cdg66/Emergency_Linux_Computer/3d models/AT24CS02_MAHM_T/AT24CS02-MAHM-T.step

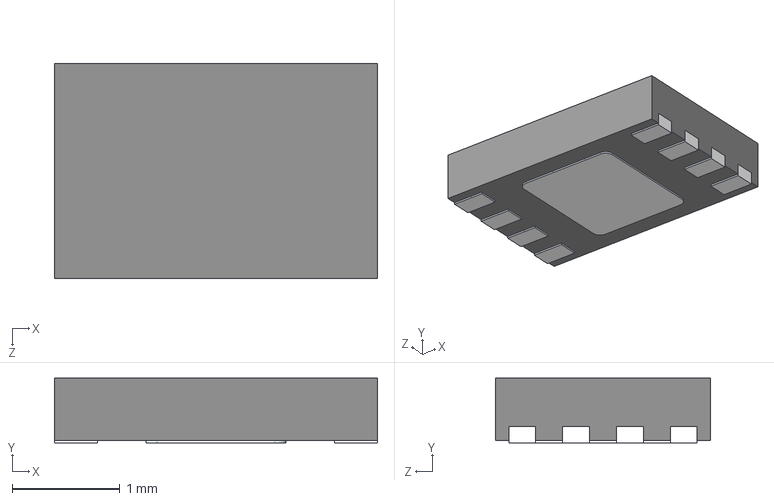
[picture p1: CAD file, 2024-12-20]
3d models/AT24CS02_MAHM_T/AT24CS02-MAHM-T.step
3.00 x 0.6 x 2.00 mm
