cdg66/Emergency_Linux_Computer/3d models/BM03B-SRSS-TB.STEP

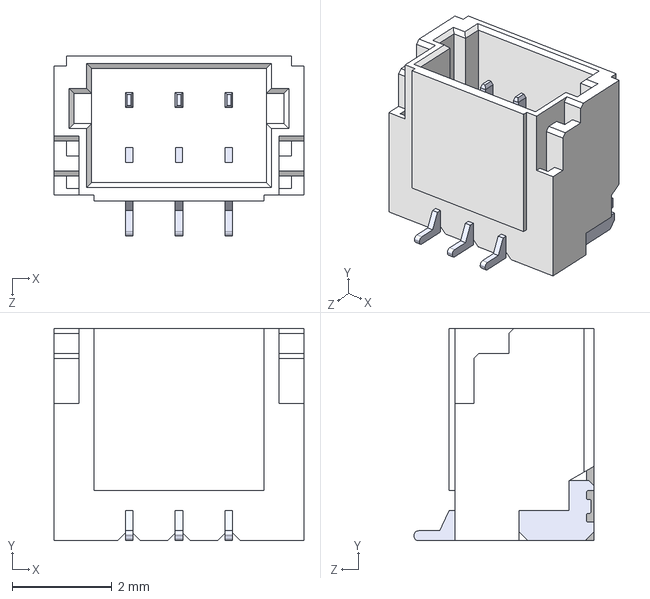
[picture p2: CAD file, 2024-12-20]
3d models/BM03B-SRSS-TB.STEP
5.00 x 4.25 x 3.60 mm
