cdg66/Emergency_Linux_Computer/3d models/SM04B-SRSS-TB.STEP

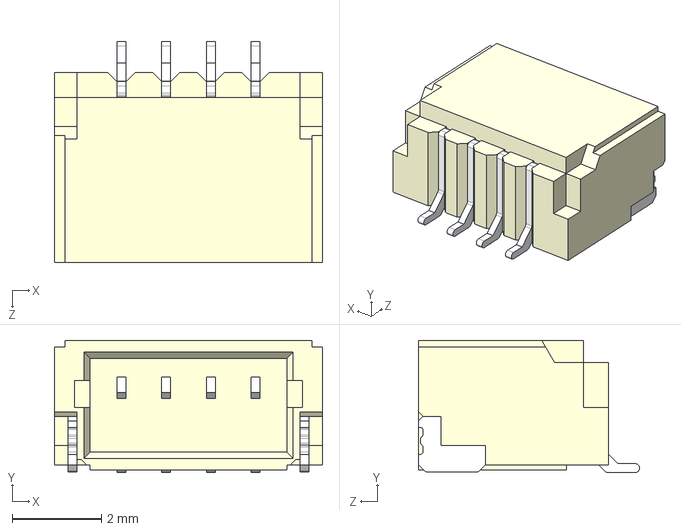
[picture p3: CAD file, 2024-12-20]
3d models/SM04B-SRSS-TB.STEP
6.00 x 2.96 x 4.95 mm
