cdg66/Emergency_Linux_Computer/3d models/W25N01GVZEIG TR.STEP

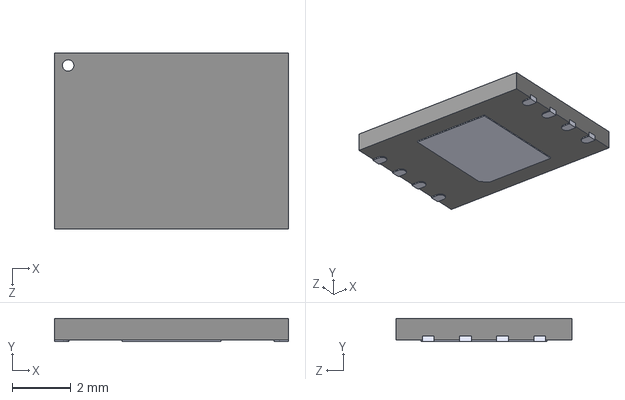
[picture p4: CAD file, 2024-12-20]
3d models/W25N01GVZEIG TR.STEP
8.00 x 0.8 x 6.00 mm
