cdg66/Emergency_Linux_Computer/3d models/EVQP7C01P--3DModel-STEP-269445.STEP

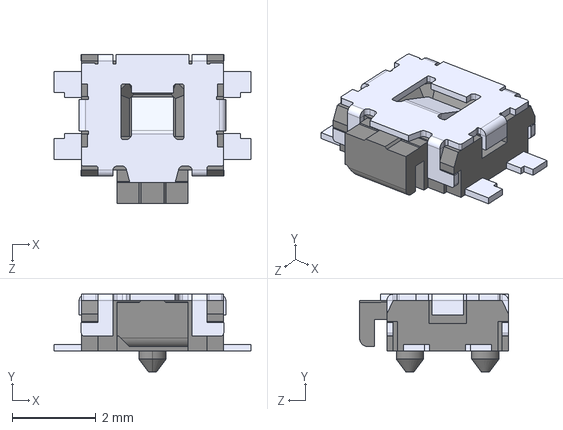
[picture p5: CAD file, 2024-12-20]
3d models/EVQP7C01P--3DModel-STEP-269445.STEP
4.70 x 1.85 x 3.55 mm
