cdg66/Emergency_Linux_Computer/3d models/0480372200.stp

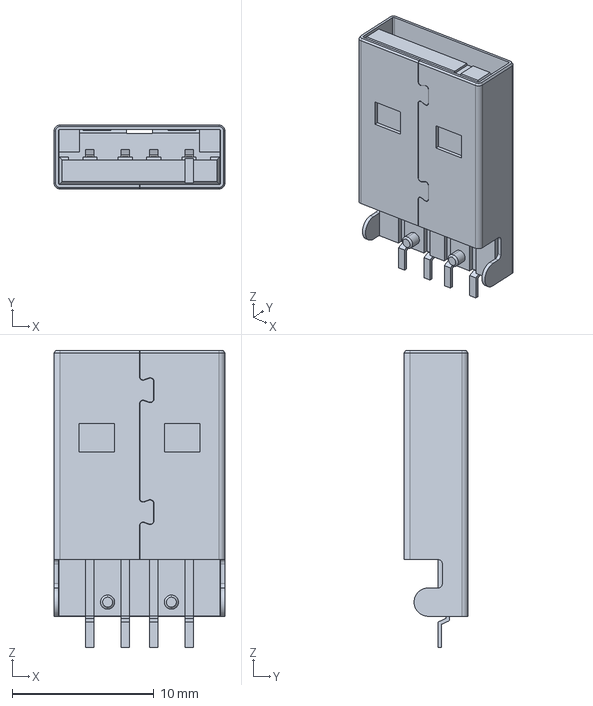
[picture p6: CAD file, 2024-12-20]
3d models/0480372200.stp
12.1 x 4.50 x 21.0 mm
