cdg66/Emergency_Linux_Computer/Emergency_Linux_Computer.kicad_pcb

## KiCad design Emergency_Linux_Computer.kicad_pcb (2024-12-20)

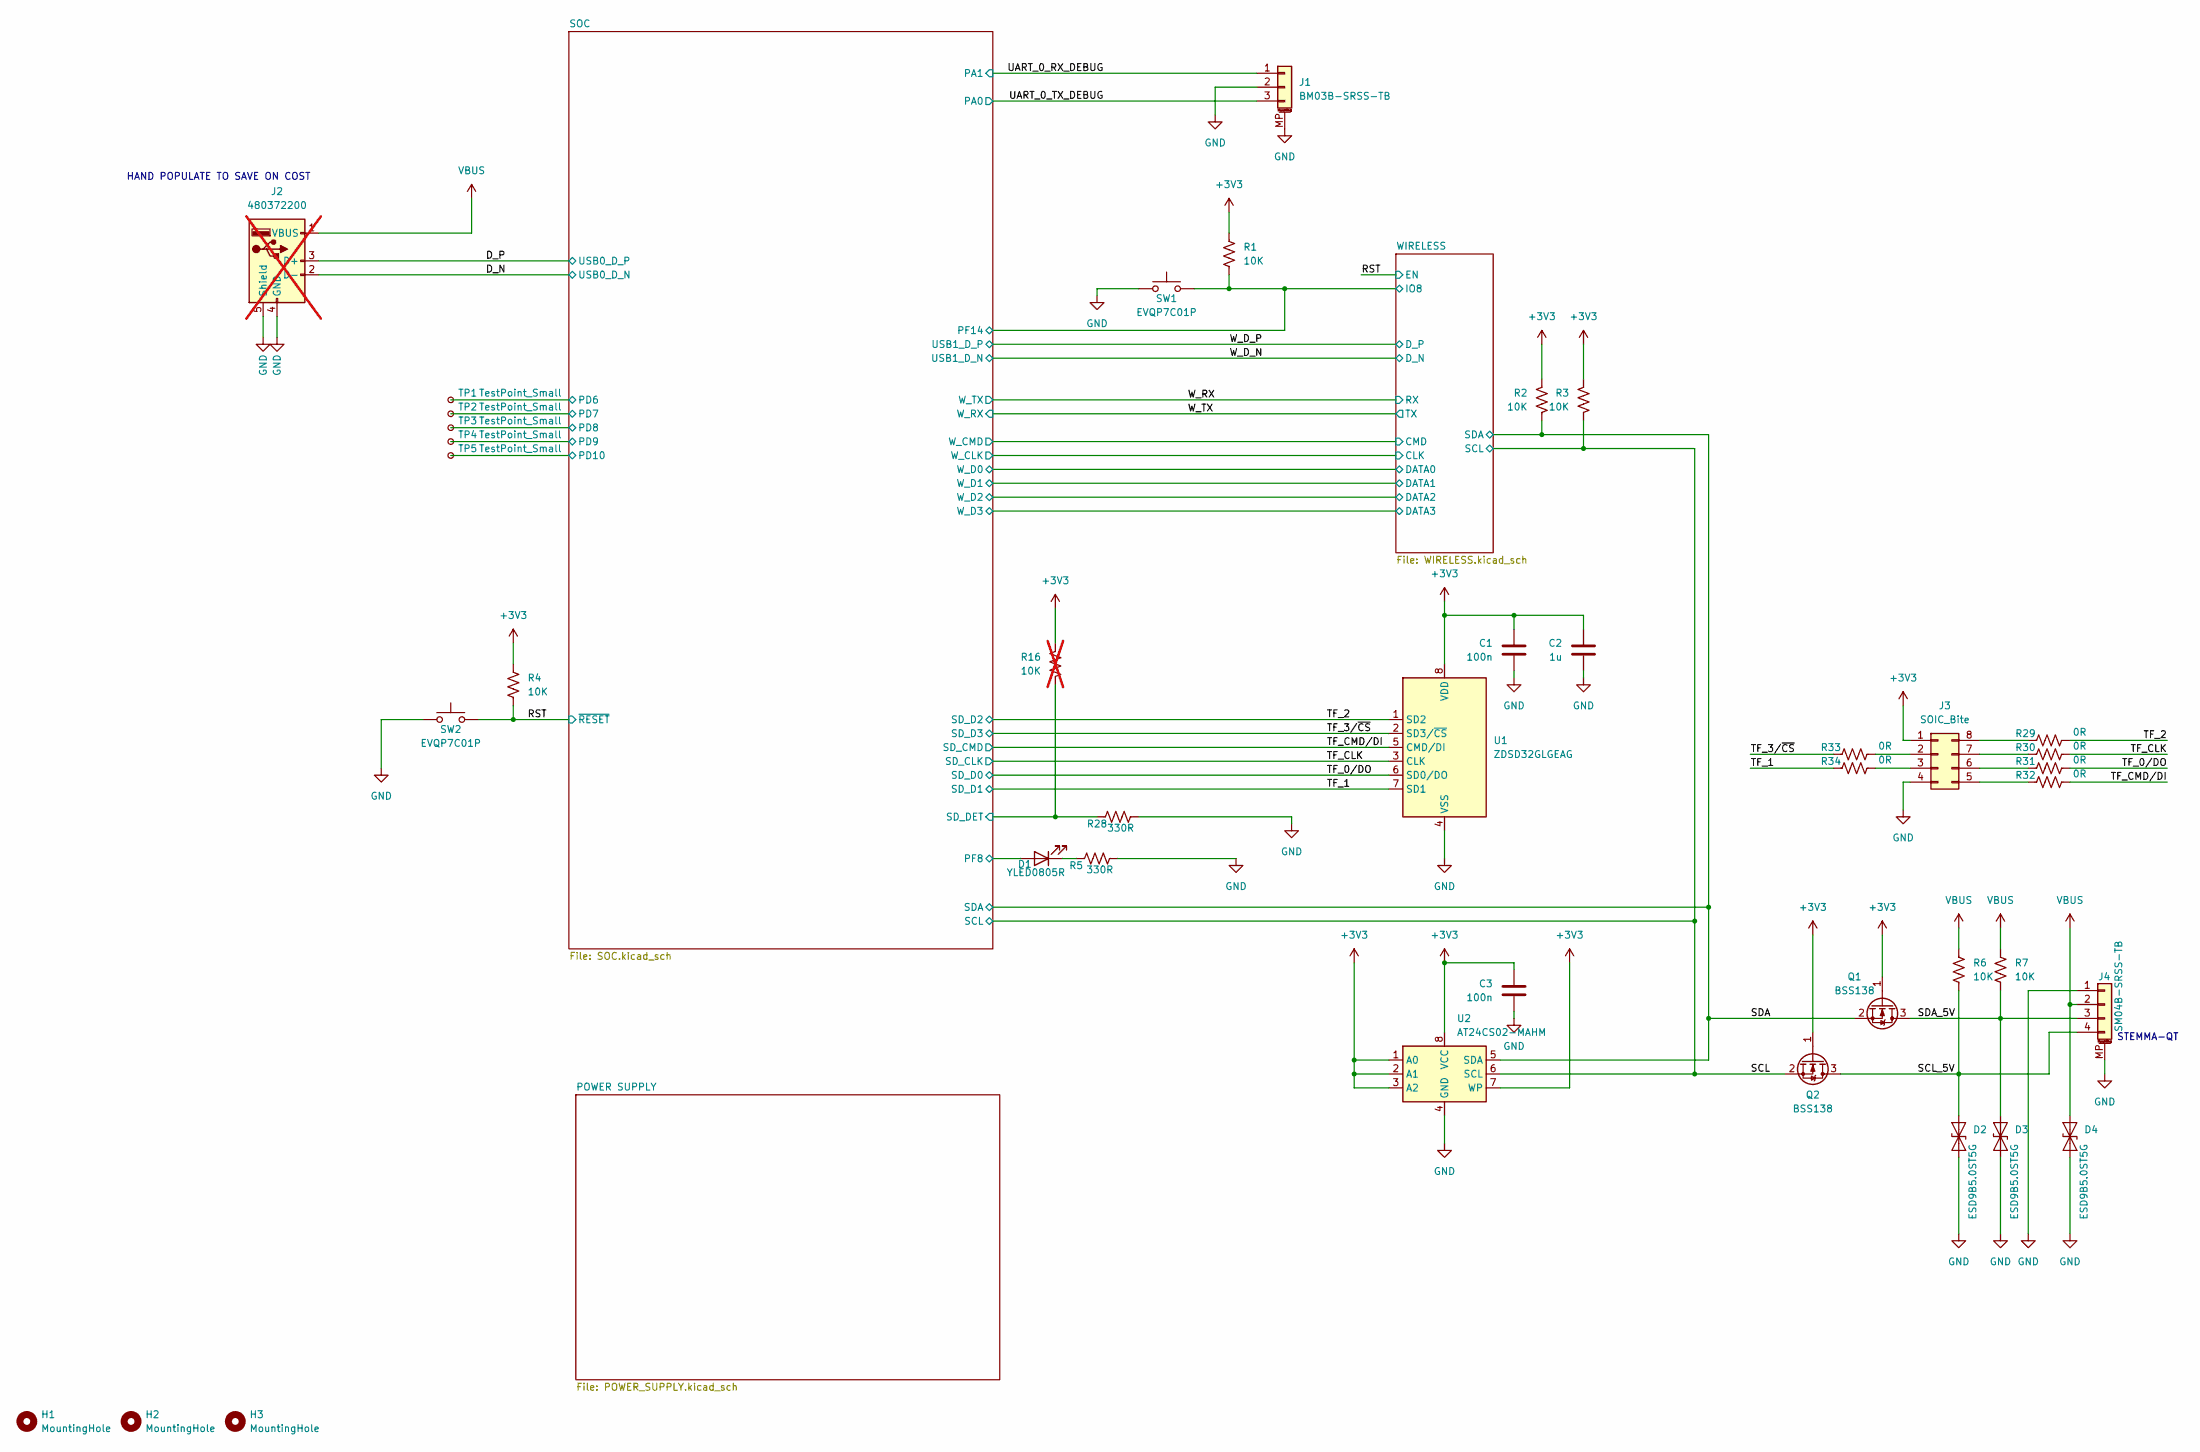
[picture p7: schematic Emergency_Linux_Computer.kicad_sch, Emergency Linux Computer]

Parts:
C1, C3: 100n; C_0201_0603Metric
C2: 1u; C_0603_1608Metric
D1: YLED0805R; LED_0805_2012Metric
D2, D3, D4: ESD9B5.0ST5G; D_SOD-923
H1, H2, H3: MountingHole; MountingHole_2.2mm_M2
J1: BM03B-SRSS-TB; JST_SH_BM03B-SRSS-TB_1x03-1MP_P1.00mm_Vertical
J2: 480372200; USB_A_Molex_48037-2200_Horizontal; not fitted
J3: SOIC_Bite; SOIC_clipProgSmall
J4: SM04B-SRSS-TB; JST_SH_SM04B-SRSS-TB_1x04-1MP_P1.00mm_Horizontal
Q1, Q2: BSS138; SOT-23
R1, R2, R3, R4, R6, R7: 10K; R_0201_0603Metric
R5, R28: 330R; R_0805_2012Metric
R16: 10K; R_0805_2012Metric; not fitted
R29, R30, R31, R32, R33, R34: 0R; R_0201_0603Metric
SW1, SW2: EVQP7C01P; SW_SPST_EVQP7C
TP1, TP2, TP3, TP4, TP5: TestPoint_Small; TestPoint_Pad_D1.0mm
U1: ZDSD32GLGEAG; LGA-8_8x6mm_P1.27mm
U2: AT24CS02-MAHM; DFN-8-1EP_3x2mm_P0.5mm_EP1.3x1.5mm

Connections:
+3V3: C1.1, C2.1, C3.1, J3.1, Q1.1 (G), Q2.1 (G), R1.1, R2.1, R3.1, R4.1, R16.1, U1.8 (VDD), U2.1 (A0), U2.2 (A1), U2.3 (A2), U2.7 (WP), U2.8 (VCC); also elsewhere on the board
/D_N: J2.2 (D-); also elsewhere on the board
/D_P: J2.3 (D+); also elsewhere on the board
/PF8: D1.2 (A)
/RST: R4.2, SW2.2; also elsewhere on the board
/SCL: Q2.2 (S), R3.2, U2.6 (SCL); also elsewhere on the board
/SCL_5V: D2.1 (A1), J4.4, Q2.3 (D), R6.2
/SDA: Q1.2 (S), R2.2, U2.5 (SDA); also elsewhere on the board
/SDA_5V: D3.1 (A1), J4.3, Q1.3 (D), R7.2
/SOC/PD6: TP1.1; also elsewhere on the board
/SOC/PD7: TP2.1; also elsewhere on the board
/SOC/PD8: TP3.1; also elsewhere on the board
/SOC/PD9: TP4.1; also elsewhere on the board
/SOC/PD10: TP5.1; also elsewhere on the board
/SOC/SD_DET: R16.2, R28.1; also elsewhere on the board
/TF_0/DO: R31.2, U1.6 (SD0/DO); also elsewhere on the board
/TF_1: R34.1, U1.7 (SD1); also elsewhere on the board
/TF_2: R29.2, U1.1 (SD2); also elsewhere on the board
/TF_3/~CS: R33.1, U1.2 (SD3/~CS); also elsewhere on the board
/TF_CLK: R30.2, U1.3 (CLK); also elsewhere on the board
/TF_CMD/DI: R32.2, U1.5 (CMD/DI); also elsewhere on the board
/UART_0_RX_DEBUG: J1.1; also elsewhere on the board
/UART_0_TX_DEBUG: J1.3; also elsewhere on the board
/WIRELESS/IO8: R1.2, SW1.2; also elsewhere on the board
GND: C1.2, C2.2, C3.2, D2.2 (A2), D3.2 (A2), D4.2 (A2), J1.2, J1.MP (MountPin), J2.4 (GND), J2.5 (Shield), J3.4, J4.1, J4.MP (MountPin), R5.2, R28.2, SW1.1, SW2.1, U1.4 (VSS), U2.4 (GND), U2.9 (GND); also elsewhere on the board
unnamed: D1.1 (K), R5.1
unnamed: J3.2, R33.2
unnamed: J3.3, R34.2
unnamed: J3.5, R32.1
unnamed: J3.6, R31.1
unnamed: J3.7, R30.1
unnamed: J3.8, R29.1
VBUS: D4.1 (A1), J2.1 (VBUS), J4.2, R6.1, R7.1; also elsewhere on the board

Notes on the sheet:
STEMMA-QT
HAND POPULATE TO SAVE ON COST

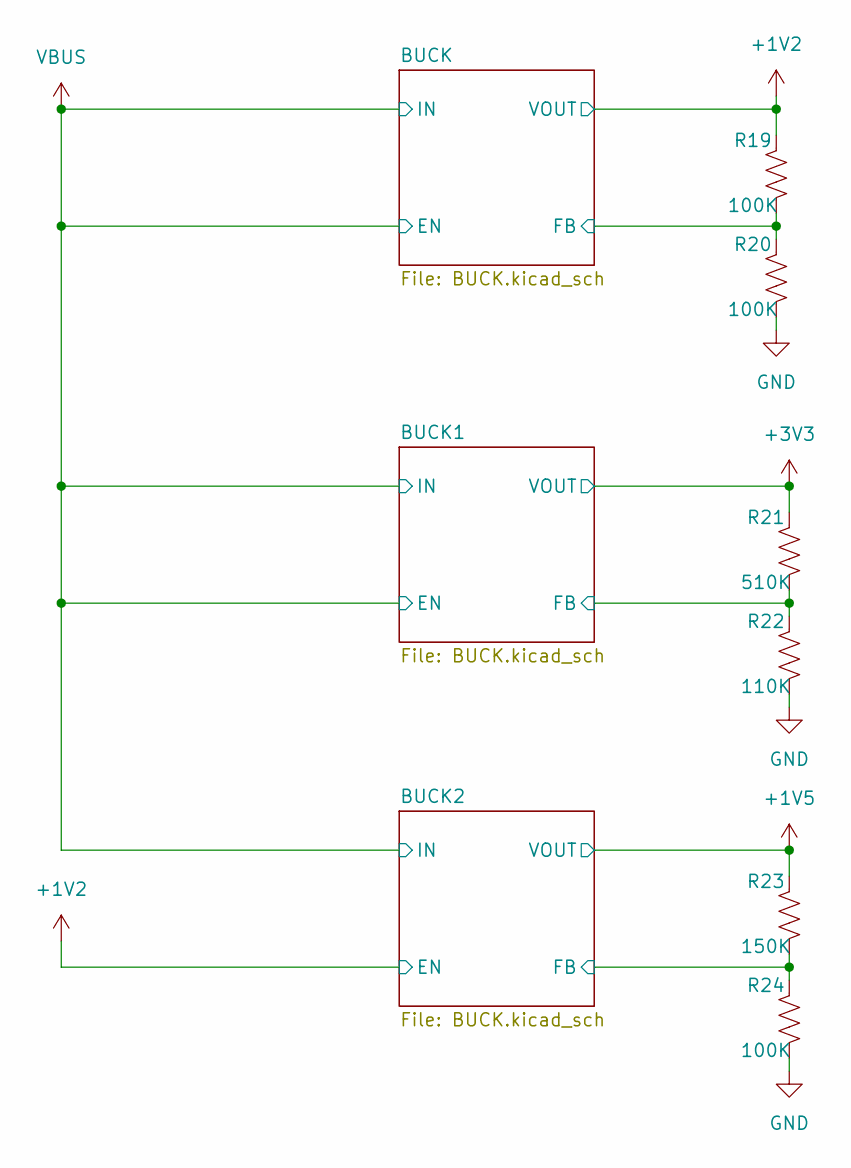
[picture p8: schematic POWER_SUPPLY.kicad_sch, Emergency Linux Computer]

Parts:
R19, R20, R24: 100K; R_0201_0603Metric
R21: 510K; R_0201_0603Metric
R22: 110K; R_0201_0603Metric
R23: 150K; R_0201_0603Metric

Connections:
+1V2: R19.1; also elsewhere on the board
+1V5: R23.1; also elsewhere on the board
+3V3: R21.1; also elsewhere on the board
/POWER SUPPLY/BUCK1/FB: R21.2, R22.1; also elsewhere on the board
/POWER SUPPLY/BUCK2/FB: R23.2, R24.1; also elsewhere on the board
/POWER SUPPLY/BUCK/FB: R19.2, R20.1; also elsewhere on the board
GND: R20.2, R22.2, R24.2; also elsewhere on the board

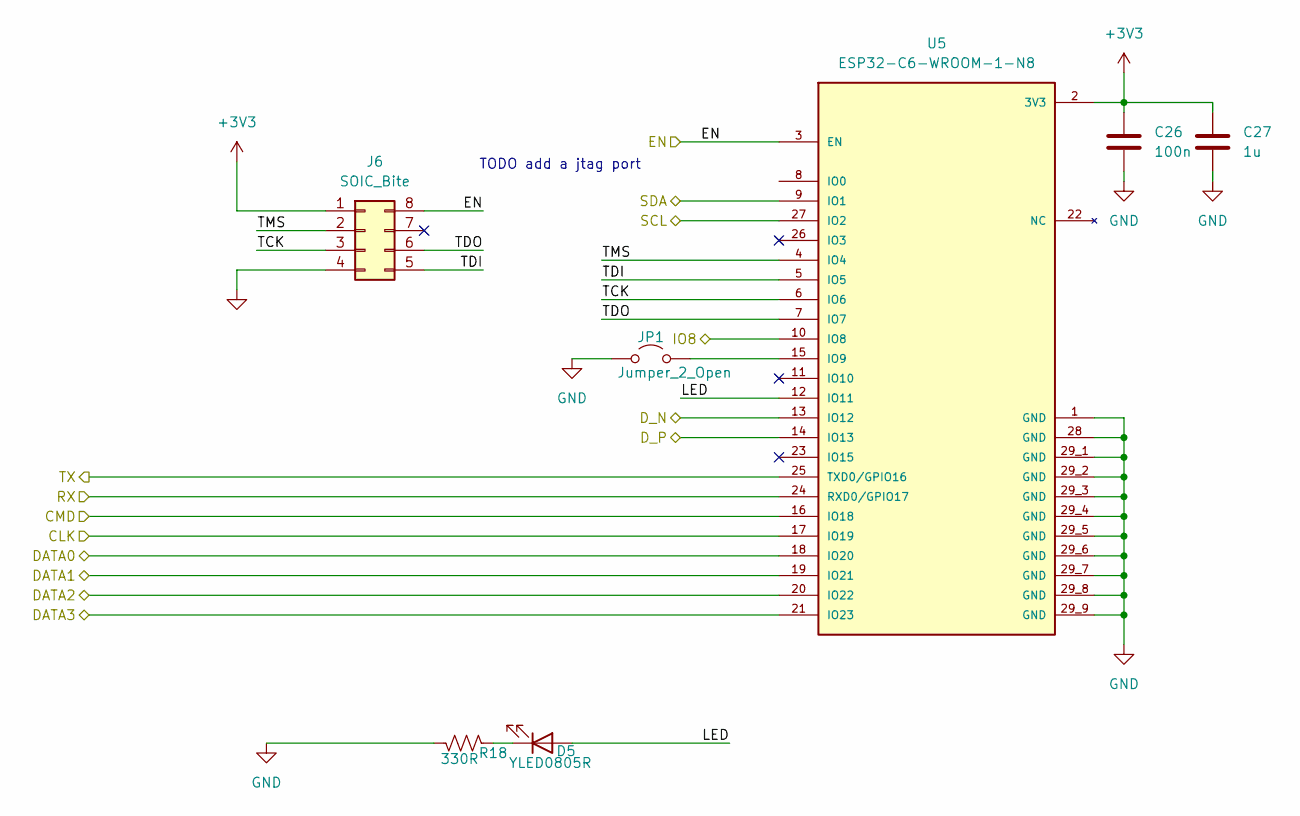
[picture p9: schematic WIRELESS.kicad_sch, Emergency Linux Computer]

Parts:
C26: 100n; C_0201_0603Metric
C27: 1u; C_0603_1608Metric
D5: YLED0805R; LED_0805_2012Metric
J6: SOIC_Bite; SOIC_clipProgSmall
JP1: Jumper_2_Open; SolderJumper-2_P1.3mm_Open_Pad1.0x1.5mm
R18: 330R; R_0805_2012Metric
U5: ESP32-C6-WROOM-1-N8; XCVR_ESP32-C6-WROOM-1-N8; PARTREV 1.0

Connections:
+3V3: C26.1, C27.1, J6.1, U5.2 (3V3); also elsewhere on the board
/RST: J6.8, U5.3 (EN); also elsewhere on the board
/SCL: U5.27 (IO2); also elsewhere on the board
/SDA: U5.9 (IO1); also elsewhere on the board
/SOC/W_CLK: U5.17 (IO19); also elsewhere on the board
/SOC/W_CMD: U5.16 (IO18); also elsewhere on the board
/SOC/W_D0: U5.18 (IO20); also elsewhere on the board
/SOC/W_D1: U5.19 (IO21); also elsewhere on the board
/SOC/W_D2: U5.20 (IO22); also elsewhere on the board
/SOC/W_D3: U5.21 (IO23); also elsewhere on the board
/WIRELESS/IO8: U5.10 (IO8); also elsewhere on the board
/WIRELESS/LED: D5.2 (A), U5.12 (IO11)
/WIRELESS/TCK: J6.3, U5.6 (IO6)
/WIRELESS/TDI: J6.5, U5.5 (IO5)
/WIRELESS/TDO: J6.6, U5.7 (IO7)
/WIRELESS/TMS: J6.2, U5.4 (IO4)
/W_D_N: U5.13 (IO12); also elsewhere on the board
/W_D_P: U5.14 (IO13); also elsewhere on the board
/W_RX: U5.24 (RXD0/GPIO17); also elsewhere on the board
/W_TX: U5.25 (TXD0/GPIO16); also elsewhere on the board
GND: C26.2, C27.2, J6.4, JP1.1 (A), R18.2, U5.1 (GND), U5.28 (GND), U5.29_1 (GND), U5.29_2 (GND), U5.29_3 (GND), U5.29_4 (GND), U5.29_5 (GND), U5.29_6 (GND), U5.29_7 (GND), U5.29_8 (GND), U5.29_9 (GND); also elsewhere on the board
unnamed: D5.1 (K), R18.1
unnamed: JP1.2 (B), U5.15 (IO9)

Notes on the sheet:
TODO add a jtag port

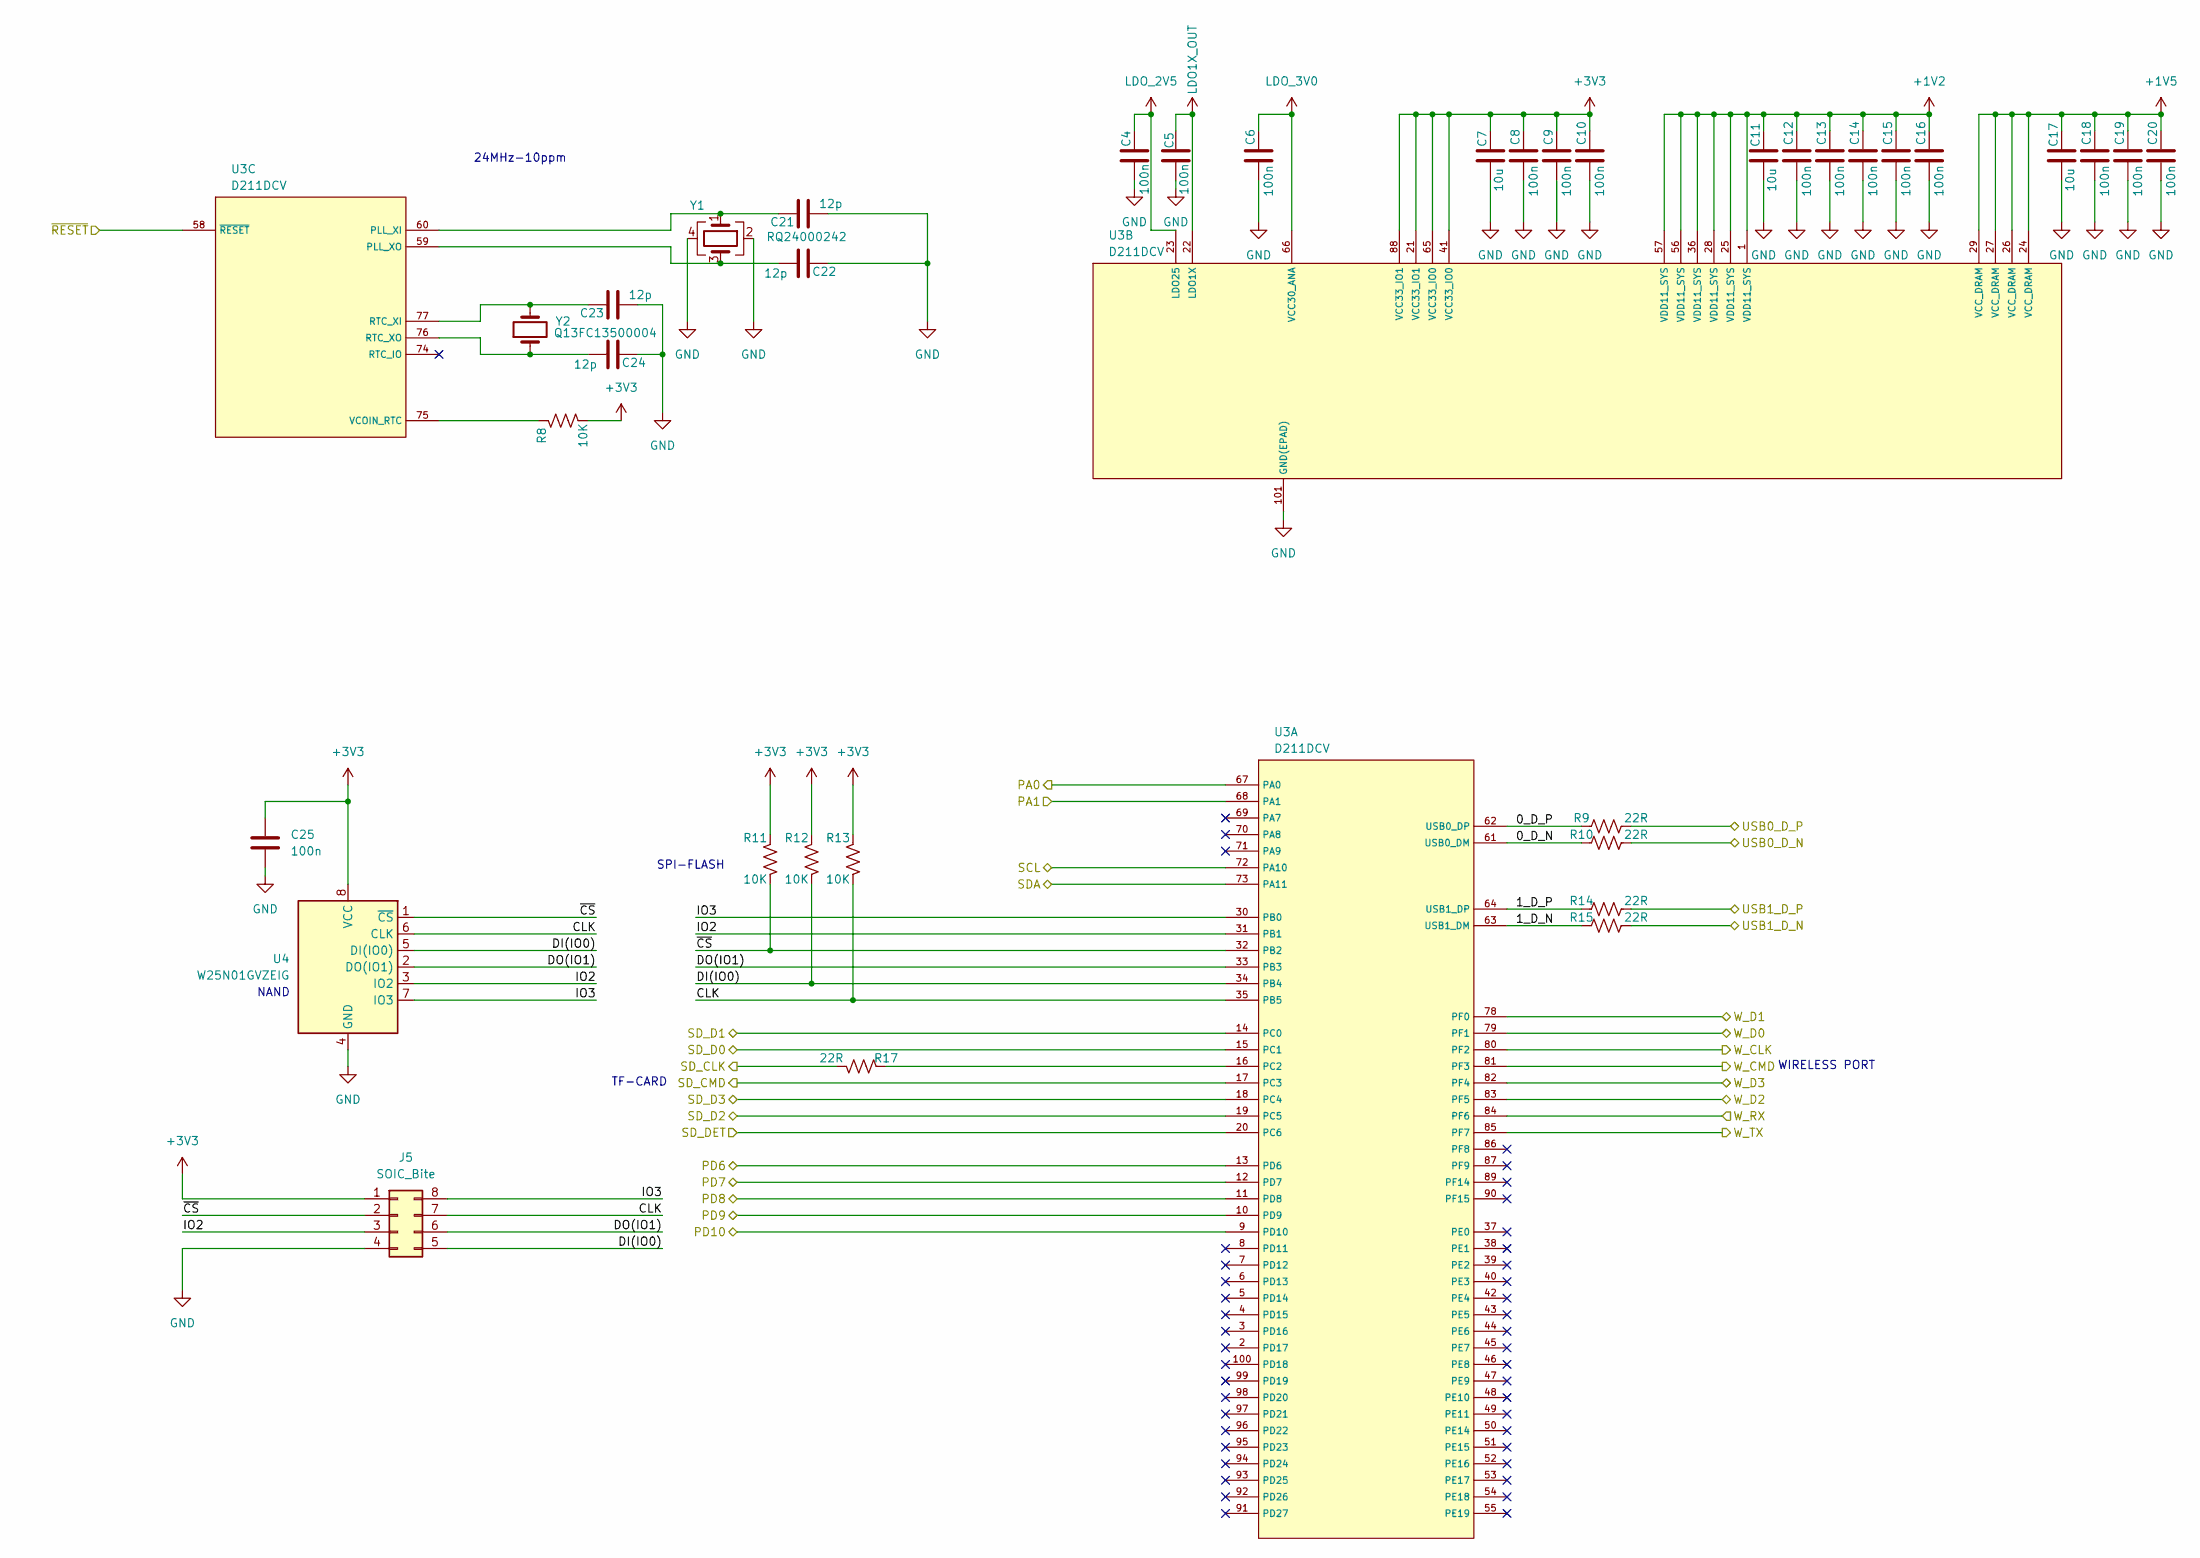
[picture p10: schematic SOC.kicad_sch, Emergency Linux Computer]

Parts:
C4, C5, C6, C8, C9, C10, C12, C13, C14, C15, C16, C18, C19, C20, C25: 100n; C_0201_0603Metric
C7, C11, C17: 10u; C_0603_1608Metric
C21, C22, C23, C24: 12p; C_0201_0603Metric
J5: SOIC_Bite; SOIC_clipProgSmall
R8, R11, R12, R13: 10K; R_0201_0603Metric
R9, R10, R14, R15, R17: 22R; R_0201_0603Metric
U3: D211DCV; ArtInChip_QFN-100-1EP_12x12mm_P0.4mm_EP7.4x7.4mm
U4: W25N01GVZEIG; WSON-8-1EP_8x6mm_P1.27mm_EP3.4x4.3mm
Y1: RQ24000242; Crystal_SMD_2520-4Pin_2.5x2.0mm
Y2: Q13FC13500004; Crystal_SMD_3215-2Pin_3.2x1.5mm

Connections:
+1V2: C11.1, C12.1, C13.1, C14.1, C15.1, C16.1, U3.1 (VDD11_SYS), U3.25 (VDD11_SYS), U3.28 (VDD11_SYS), U3.36 (VDD11_SYS), U3.56 (VDD11_SYS), U3.57 (VDD11_SYS); also elsewhere on the board
+1V5: C17.1, C18.1, C19.1, C20.1, U3.24 (VCC_DRAM), U3.26 (VCC_DRAM), U3.27 (VCC_DRAM), U3.29 (VCC_DRAM); also elsewhere on the board
+3V3: C7.1, C8.1, C9.1, C10.1, C25.1, J5.1, R8.2, R11.1, R12.1, R13.1, U3.21 (VCC33_IO1), U3.41 (VCC33_IO0), U3.65 (VCC33_IO0), U3.88 (VCC33_IO1), U4.8 (VCC); also elsewhere on the board
/D_N: R10.2; also elsewhere on the board
/D_P: R9.2; also elsewhere on the board
/RST: U3.58 (~RESET); also elsewhere on the board
/SCL: U3.72 (PA10); also elsewhere on the board
/SDA: U3.73 (PA11); also elsewhere on the board
/SOC/0_D_N: R10.1, U3.61 (USB0_DM)
/SOC/0_D_P: R9.1, U3.62 (USB0_DP)
/SOC/1_D_N: R15.1, U3.63 (USB1_DM)
/SOC/1_D_P: R14.1, U3.64 (USB1_DP)
/SOC/CLK: J5.7, R13.2, U3.35 (PB5), U4.6 (CLK)
/SOC/DI(IO0): J5.5, R12.2, U3.34 (PB4), U4.5 (DI(IO0))
/SOC/DO(IO1): J5.6, U3.33 (PB3), U4.2 (DO(IO1))
/SOC/IO2: J5.3, U3.31 (PB1), U4.3 (IO2)
/SOC/IO3: J5.8, U3.30 (PB0), U4.7 (IO3)
/SOC/PD6: U3.13 (PD6); also elsewhere on the board
/SOC/PD7: U3.12 (PD7); also elsewhere on the board
/SOC/PD8: U3.11 (PD8); also elsewhere on the board
/SOC/PD9: U3.10 (PD9); also elsewhere on the board
/SOC/PD10: U3.9 (PD10); also elsewhere on the board
/SOC/SD_DET: U3.20 (PC6); also elsewhere on the board
/SOC/W_CLK: U3.80 (PF2); also elsewhere on the board
/SOC/W_CMD: U3.81 (PF3); also elsewhere on the board
/SOC/W_D0: U3.79 (PF1); also elsewhere on the board
/SOC/W_D1: U3.78 (PF0); also elsewhere on the board
/SOC/W_D2: U3.83 (PF5); also elsewhere on the board
/SOC/W_D3: U3.82 (PF4); also elsewhere on the board
/SOC/~CS: J5.2, R11.2, U3.32 (PB2), U4.1 (~CS)
/TF_0/DO: U3.15 (PC1); also elsewhere on the board
/TF_1: U3.14 (PC0); also elsewhere on the board
/TF_2: U3.19 (PC5); also elsewhere on the board
/TF_3/~CS: U3.18 (PC4); also elsewhere on the board
/TF_CLK: R17.2; also elsewhere on the board
/TF_CMD/DI: U3.17 (PC3); also elsewhere on the board
/UART_0_RX_DEBUG: U3.68 (PA1); also elsewhere on the board
/UART_0_TX_DEBUG: U3.67 (PA0); also elsewhere on the board
/W_D_N: R15.2; also elsewhere on the board
/W_D_P: R14.2; also elsewhere on the board
/W_RX: U3.85 (PF7); also elsewhere on the board
/W_TX: U3.84 (PF6); also elsewhere on the board
GND: C4.2, C5.2, C6.2, C7.2, C8.2, C9.2, C10.2, C11.2, C12.2, C13.2, C14.2, C15.2, C16.2, C17.2, C18.2, C19.2, C20.2, C21.2, C22.1, C23.2, C24.1, C25.2, J5.4, U3.101 (GND(EPAD)), U4.4 (GND), U4.9 (GND), Y1.2, Y1.4; also elsewhere on the board
LDO1X_OUT: C5.1, U3.22 (LDO1X)
LDO_2V5: C4.1, U3.23 (LDO25)
LDO_3V0: C6.1, U3.66 (VCC30_ANA)
unnamed: R17.1, U3.16 (PC2)
unnamed: C21.1, U3.60 (PLL_XI), Y1.1
unnamed: C22.2, U3.59 (PLL_XO), Y1.3
unnamed: C23.1, U3.77 (RTC_XI), Y2.2
unnamed: C24.2, U3.76 (RTC_XO), Y2.1
unnamed: R8.1, U3.75 (VCOIN_RTC)

Notes on the sheet:
24MHz-10ppm
SPI-FLASH
WIRELESS PORT
NAND
TF-CARD

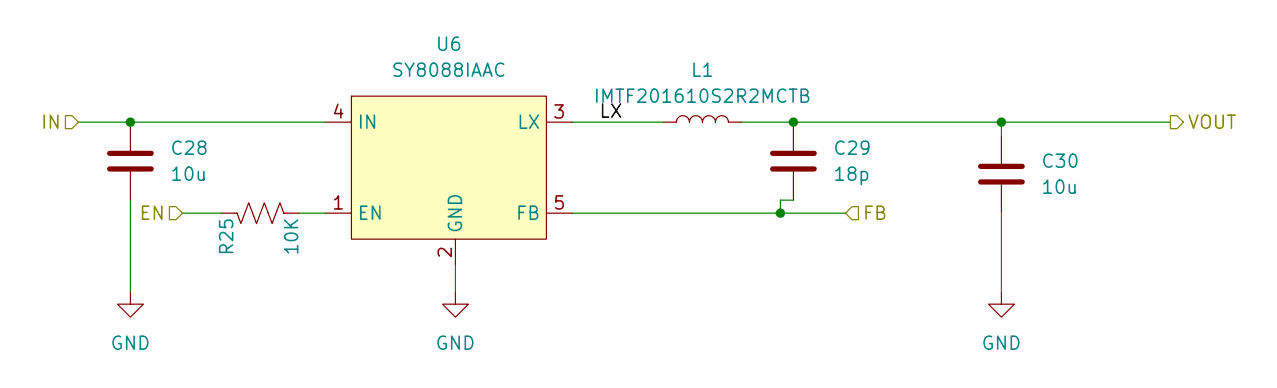
[picture p11: schematic BUCK.kicad_sch, Emergency Linux Computer]

Parts:
C28, C30: 10u; C_0603_1608Metric
C29: 18p; C_0201_0603Metric
L1: IMTF201610S2R2MCTB; L_Murata_DFE201610P
R25: 10K; R_0201_0603Metric
U6: SY8088IAAC; SOT-23-5

Connections:
+1V2: C29.1, C30.1, L1.2; also elsewhere on the board
/POWER SUPPLY/BUCK/FB: C29.2, U6.5 (FB); also elsewhere on the board
/POWER SUPPLY/BUCK/LX: L1.1, U6.3 (LX)
GND: C28.2, C30.2, U6.2 (GND); also elsewhere on the board
unnamed: R25.2, U6.1 (EN)
VBUS: C28.1, R25.1, U6.4 (IN); also elsewhere on the board

Parts of its further copies:
C31, C33, C34, C36: 10u; C_0603_1608Metric
C32, C35: 18p; C_0201_0603Metric
L2, L3: IMTF201610S2R2MCTB; L_Murata_DFE201610P
R26, R27: 10K; R_0201_0603Metric
U7, U8: SY8088IAAC; SOT-23-5

Connections of its further copies:
+1V2: R27.1; also elsewhere on the board
+1V5: C35.1, C36.1, L3.2; also elsewhere on the board
+3V3: C32.1, C33.1, L2.2; also elsewhere on the board
/POWER SUPPLY/BUCK1/FB: C32.2, U7.5 (FB); also elsewhere on the board
/POWER SUPPLY/BUCK1/LX: L2.1, U7.3 (LX)
/POWER SUPPLY/BUCK2/FB: C35.2, U8.5 (FB); also elsewhere on the board
/POWER SUPPLY/BUCK2/LX: L3.1, U8.3 (LX)
GND: C31.2, C33.2, C34.2, C36.2, U7.2 (GND), U8.2 (GND); also elsewhere on the board
unnamed: R26.2, U7.1 (EN)
unnamed: R27.2, U8.1 (EN)
VBUS: C31.1, C34.1, R26.1, U7.4 (IN), U8.4 (IN); also elsewhere on the board

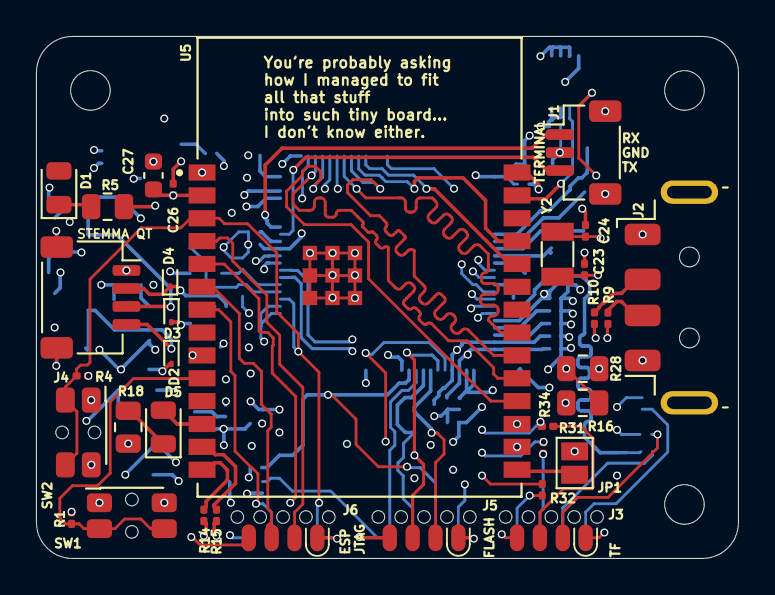
[picture p12: board Emergency_Linux_Computer.kicad_pcb from above]

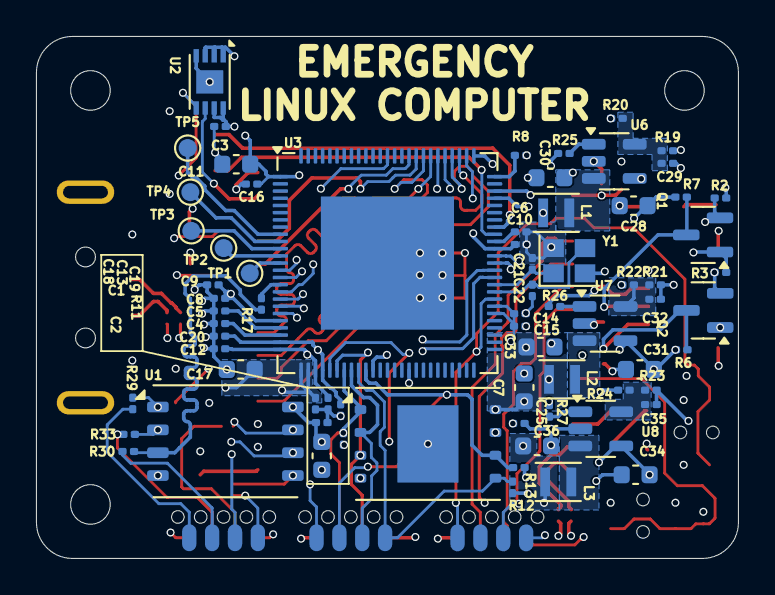
[picture p13: board Emergency_Linux_Computer.kicad_pcb from below]

Board: 8 copper layers, 39.0 x 29.0 mm, 107 parts (71 on the bottom side), 79 nets.
